jbousselot/ez-Ra-Sawbird-ESP32c6/(commit log)

2025-11-22 Create esp32_C6_pin_change_query_ext-ant.ino
    for Seeed Studio ESP32c6 with external antenna port. Modify antenna selection for other modules like C3
2025-11-22 Create operate.py
    ezRa software passes two args to the switching utility. If there is only one device to switch, the second argv is not implemented
2025-12-20 Create operate-v2.py
    Added short timeout value and http response codes to assist with debugging. This performs the same function but with a more organized approach. If the ESP32 were offline, the command will fail much faster than default timeouts.
    [operate-v2.py]
2025-12-26 Create esp32_C6_pin_change_query_ext_ant_static-IP.ino
    code used in production - December 5, 2025, STATIC IP
2026-05-25 Create esp32-c6-50ohm-weather-diag-candidate.ino
    candidate for adding additional data collection (separate from ezRA) and some diagnostic output for debugging
2026-09-06 Update esp32-c6-50ohm-weather-diag-candidate.ino
    more debug, API formatting for weather, disable WiFi sleep
2026-09-06 Create esp32-weatherlog.py
    Weather collection python script
2026-09-07 Update operate-v2.py
    logic for ON/OFF was inverted. ON is used to invoke the 50ohm reference by taking the Sawbird pin high. OFF is default at bootup, the pin is low, and RF passes through the LNA normally.
    [operate-v2.py]
